Duanyll/LedClock/doc/lab_report(zh_cn).pdf

# 2021 年电子科技大学盟升杯电子设计

竞赛

# 设 计 报 告

# D 题 多功能闹钟

# 2021 年电子科技大学盟升杯电子设计竞赛

设 | 计 | 报 | 告

## 题目：新生组 D 题 多功能小车

## 一、 摘要

## 本小组制作的多功能闹钟主要由 STM32 单片机最小系统、数码管模块、按键

## 模块、光敏电阻模块、稳压电源模块、蜂鸣器模块、DHT11 温湿度传感器模块和备

## 用电池模块组成。本设计采用了双层洞洞板设计，STM32 单片机最小系统板、稳

## 压电源、备用电池位于下层板，数码管、按钮、光敏电阻、温湿度传感器和蜂鸣器

## 等交互模块位于上层板，上下两层板通过排针连接，整体结构设计合理，空间利用

## 率高。用户能通过上下左右四个按键直观地与本作品进行交互，能通过 LED 数码

## 管显示的功能菜单完成时间设置、温湿度查看、闹钟设置等功能。本作品内置了

## 几首蜂鸣器音乐用户选择作为闹钟铃声。除题目要求的功能外，本作品还实现了

## 秒表和倒计时功能。本组的设计能较好地完成多功能闹钟的任务。

## 二、 系统方案

（一）电路载体选择

## 1） 单层洞洞板

## 2） 双层洞洞板

### 3） PCB

选择：（3）

## 分析：单层洞洞板设计、制作和调试难度均较低，但空间利用率不高，不够美

## 观；双层洞洞板将不与用户交互的模块置于背面，同时提供额外空间进行走线，但

## 设计、制作和调试较为复杂；PCB 能提供最稳定和美观的效果，但是设计、加工、

## 调试周期较长，成本较高。综合考虑各种因素后，我们选择使用双层洞洞板。

（二）供电选择

### 1） 自治 LM7805 9V 转 5V 稳压电源模块

### 2） USB 5V 电源输入

## 3） 调试端口 3V3 电源输入

选择：（1）（2）（3）

## 分析：题目要求采用（1）方式供电，但最小系统板自带后两种供电方式支持，

## 配置较为方便。

（三）按钮输入方式选择

## 1） 开漏输出

## 2） 推挽输出，上拉输入

选择：（2）

## 分析：开漏输入需要手动连接上拉电阻，方案 2 通过软件切换 GPIO 引脚的输

## 入方式，可免去上拉电阻，电路设计更加简洁，故采用方案 2。

（四）小结

## 经过小组同学的讨论，我们决定选择在双层洞洞板上制作作品，同时采用三

## 种供电方式，使用上拉电阻模式连接按钮，通过切换 GPIO 模式控制 DHT11 的创

## 新设计方案。

## 三、 理论分析与计算

（一）系统结构的分析

## 3.1.1 系统理论

## 通过对题目要求的分析，多功能闹钟是一个以 STM32 单片机最小系统为控制

## 核心且外附各类组件以完成各项功能的系统。需要外接进行控制的模块有：数码

## 管模块、按键模块、光敏电阻模块、蜂鸣器模块和 DHT11 温湿度传感器模块。

## 3.1.2 数码管模块理论

## 直接将单片机 GPIO 引脚连接数码管阳极和阴极，每次将共阴数码管的一个

## 阴极置为低电平，其余为高电平，将数码需点亮的笔画的阳极置于高电平，其余

## 阳极为低电平，来点亮一位数码，编程控制快速依次点亮四位数码达到同时显示

## 四位数码的效果。为实现显示亮度调节，将阴极四个引脚连接到 STM32 的定时器

## PWM 输出引脚，通过改变 PWM 占空比实现亮度调节。

## 3.1.3 按键模块理论

## 将四个按钮的一端与单片机的四个上拉输入引脚相连，另一端接地。单片机

## 每隔一定时间检测一次按钮引脚电位，按钮未按下时处于高电位，按下时处于低

## 电位。为实现按键防抖，只有连续几次探测到低电位时才出发按键处理程序。

## 3.1.4 光敏电阻模块理论

## 将光敏电阻与一定大小的电阻串联后接在 VCC 与 GND 之间，利用单片机

## ADC 检测光敏电阻和定值电阻之间的电压，即可根据串联分压原理获取光敏电阻

## 阻值，进而获得光线强度。

## 3.1.5 蜂鸣器模块理论

## 采用无源蜂鸣器，向蜂鸣器施加 PWM 方波电压即可控制蜂鸣器发声及发生

## 频率。编程连续按照录入的乐谱改变频率即可实现音乐播放。由于蜂鸣器正常工

## 作时电压和电流较大，而单片机引脚输出电流电压有限，需通过三极管放大电流。

## 3.1.6 DHT11 温湿度传感器模块理论

## DHT11 温湿度传感器通过数字方式与 STM32 主机通信，查阅其技术手册可

## 获得读取数据所用的具体通讯协议，编程实现该协议即可。

（二）相关计算

## 3.2.1 数码管 LED 限流电阻

## 单片机引脚输出电压为 3.3V，LED 工作电流约 2mA，正向电压约 2.6V，计算

## 得需串联约 260Ω 的电阻，通过并联两个 350Ω 电阻来近似实现。

## 3.2.2 与光敏电阻串联的电阻

## 用万用表测得光敏电阻在阴天太阳光下电阻约 2kΩ，完全遮挡约 18kΩ ，串联

## 一个 3.5kΩ 的电阻可以明显测量两端电压变化。

## 3.2.3 音乐播放

## 使用状态机模型驱动音乐播放程序，规定每秒调用音乐播放程序 50 次，结合

## 音乐节奏计算，可得约 3 次循环播放一个十六分音符较为适合。SysTick 计时器频

## 率为 8MHz，除以每个音高的标准频率可计算 PWM 周期。

## 四、 电路设计

（一）系统总体框图

## 系统总体框图已由题目要求给出。

## 下面是各个模块的电路原理图。

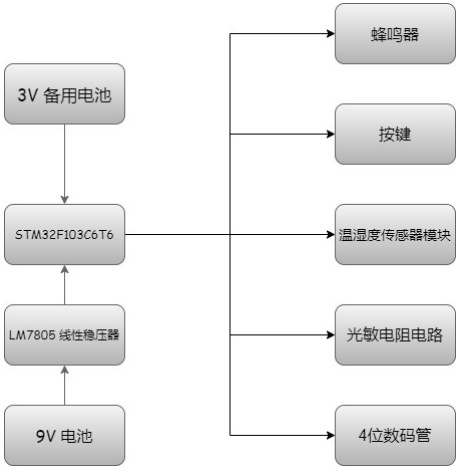
[picture p13: figure]

图 1: 系统总体框图

（二）稳压电源模块


图 2: 稳压电源模块原理图

## 其中 C1 电容用三个 10F 电容并联代替。

（三）备用电池模块

## 通过二极端接入 3.3V 输入，允许主电源接通时不消耗备用电池。使用一个 104

## 滤波电容。

（四）蜂鸣器模块

## 使用 NPN 型三极管 S8050 在接地端控制电流。


图 3: 备用电池模块原理图

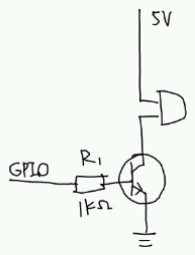
[picture p14: figure]

图 4: 蜂鸣器模块原理图

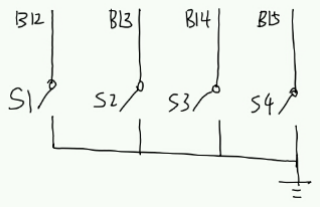
[picture p15: figure]

图 5: 按键模块原理图

（五）按键模块

## 按键一端接单片机上拉输入引脚，一端接地。

（六）DHT11 温湿度传感器模块

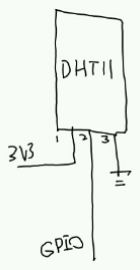
[picture p16: figure]

图 6: DHT11 温湿度传感器模块原理图

## 成品 DHT11 模块已包含电源滤波电容，直接将数据线连接单片机 GPIO。

（七）光敏电阻模块

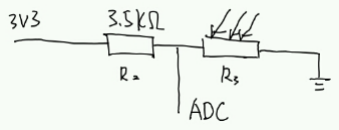
[picture p17: figure]

图 7: 光敏电阻模块原理图

## 光敏电阻阻值随光强减小，则 ADC 读取的电压值与光照强度负相关。

（八）LED 数码管模块

## 12 个管脚均直接由单片机 GPIO 控制。由于阴极数量较少，将限流电阻设置

## 在阴极，并将阴极连接到带 PWM 输出功能的引脚实现亮度调节。

（九）各模块与 STM32 核心板连接

## 4.9.1 单层洞洞板方案

## 我们论证了该方案的可行性，并做出了洞洞板布局设计，但并未实际使用。

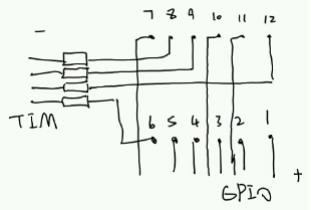
[picture p18: figure]

图 8: LED 数码管模块原理图


图 9: 数码管内部原理图

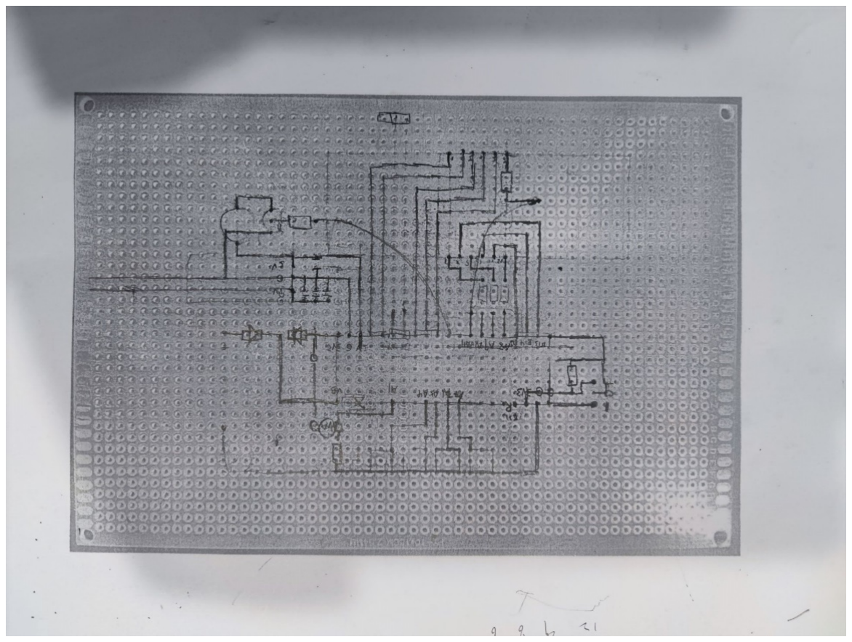
[picture p19: figure]

图 10: 单层洞洞板设计图

## 4.9.2 双层洞洞板方案

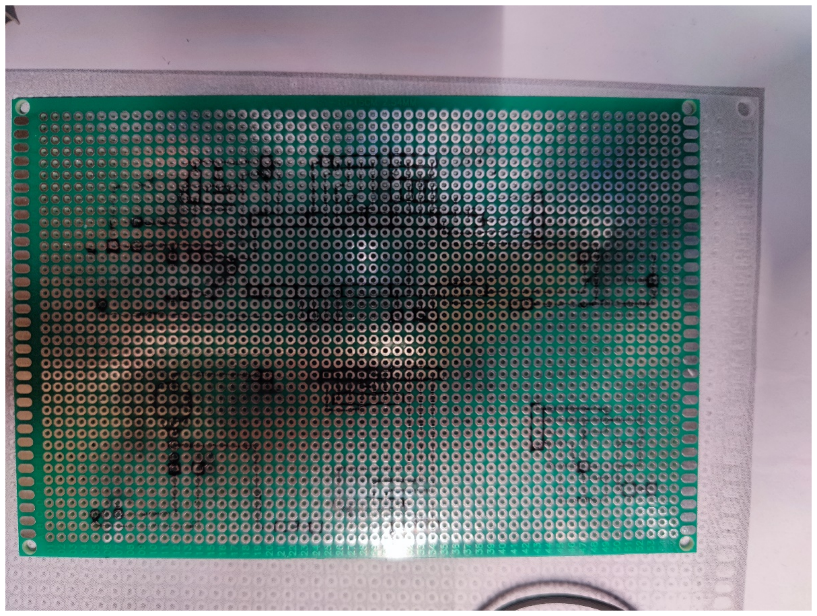
[picture p20: figure]

图 11: 双层洞洞板设计图

## 方便起见，我们直接在洞洞板上绘制了线路连接方案，整体采用紧凑型设计，

## 仅使用一条飞线，其余电路均通过焊锡连接。完成元件焊接和线路焊接后，用美

## 工刀沿中线裁开洞洞板，再利用排针完成上下两层板，下层板和单片机核心板之

## 间的物理连接和电气连接，排针两端均焊死以提升结构强度。主电源开关通过向

## 外弯折的排针固定在下层板侧边。


图 12: CubeMX 管脚配置

## 五、 测试方案与结果

（一）方案论证测试

## 在正式制作开始前，我们制作了一块测试板，通过杜邦线与单片机连接进行

## 各模块测试。

（二）单元测试

## 在连接单片机前，将各模块与稳压电源、函数发生器和多用电表等仪器相连，

## 模拟输入，检测其是否工作正常。

## LED 数码管：将稳压电源调为 3.3V，分别于每个阳极和阴极相连，观察到每

## 个数码管笔画均能正常发光。

## 按钮：将多用电表设置为蜂鸣模式，两表笔接于开关两端，按下按钮时多用电

## 表能发出蜂鸣。

## 光敏电阻：将稳压电源输出 3.3V 电源接入光敏电阻模块，使用多用电表电压

## 档测量光敏电阻两侧电压，在不同光照条件下能在 1.17V 至 2.60V 间变化。

## 稳压电源：在 LM7805 的 1 引脚和 2 引脚间施加 9.0V 电压，使用多用电表电

## 压挡测得引脚 3 和 2 间输出 4.73V 电压，基本符合要求。

## 蜂鸣器：使用稳压电源输出 5.0V 电源，函数发生器产生 2700Hz，3.3Vpp 方

## 波接入模块，能听到蜂鸣器发出响亮声音，且音高能随函数发生器频率变化。

## UART 串口：通过 USB 转 TTL 模块连接单片机的 USART 引脚和电脑并烧录

## 串口测试程序，单片机能正确回传电脑发送的数据。

## DHT11 模块：连接 UART 串口后，编程使单片机每秒向电脑发送一次从 DHT11

## 获取的温湿度数据，基本符合现实情况。

（三）集成测试

## 完成最小系统板的焊接工作，并完成程序编写后，按照用户的正常使用方式

## 测试各项功能是否正常。经测试，时间显示、时间设置、亮度调节、断电走时、温

## 湿度显示、闹钟设置、音乐播放等各项功能均能正常工作。测试时具体操作方式

## 参见附录使用说明。

## 六、 程序设计

（一）主要思路

## 本作品的主要交互方式为 LED 数码管，故整体软件设计围绕数码管显示展开。

## 经过测试，以 50Hz 的频率循环点亮四位数码管不会造成明显的闪烁效果，且延时

## 函数易于编写，故确定刷新率为 50Hz，以 20ms 为一周期进行一轮数码管渲染、数

## 据读取、蜂鸣器控制等操作，实现为以下主 while 循环：

1 | while (1) {
2 | Keys_Tick();
3 | Light_Tick();
4 | App_Tick();
5 | LED_Flush();
6 | UART_Flush();
7 | }
| 代码 1: 主 while 循环

（二）LED 驱动

## 每次通过设置阳极管脚高电平，阴极管脚启动 PWM 来点亮一位数码，保持

## 1ms 后恢复，并驱动下一位数码。每刷新周期重复 20 次，阻塞 20ms。

## 全局变量 display_buffer 用于收集交互逻辑模块绘制的图形，传递给 LED 驱动

## 模块以显示。

1 | static void LED_ShowPos(uint16_t channel, uint16_t ch_pin, uint32_t delay) {
2 | __HAL_TIM_SET_COMPARE(&htim1, channel, brightness);
3
4 | HAL_GPIO_WritePin(GPIOB, ch_pin, GPIO_PIN_SET);
5 | HAL_Delay(delay);
6 | HAL_GPIO_WritePin(GPIOB, ch_pin, GPIO_PIN_RESET);
7
8 | __HAL_TIM_SET_COMPARE(&htim1, channel, 255);
9 | }
10
11 | static void LED_Flush() {
12 | for (int i = 0; i < 5; i++) {

13 | LED_ShowPos(LED_DIG1_CH , display_buffer[0], 1);
14 | LED_ShowPos(LED_DIG2_CH , display_buffer[1], 1);
15 | LED_ShowPos(LED_DIG3_CH , display_buffer[2], 1);
16 | LED_ShowPos(LED_DIG4_CH , display_buffer[3], 1);
17 | }
18 | }
| 代码 2: LED 驱动

（三）按钮防抖判定

## 借助 20ms 周期的主循环，每循环调用一次按钮处理函数，可实现 20ms 间隔

## 的采样，要求连续多次采样成功才触发按键处理，并设置相应标志变量供交互模

## 块处理。采样函数内置静态计数器变量，可实现不同的长按按钮触发方式。

1 | uint8_t key_config[4];
2 | static void Keys_Tick() {
3 | static int hits[4] = {0};
4 | static uint16_t keys[] = {BTN_L_Pin, BTN_R_Pin, BTN_U_Pin, BTN_D_Pin};
5 | for (int i = 0; i < 4; i++) {
6 | GPIO_PinState state = HAL_GPIO_ReadPin(GPIOB, keys[i]);
7 | if (state) {
8 | hits[i] = 0;
9 | key_state[i] = FALSE;
10 | } else {
11 | hits[i]++;
12 | switch (key_config[i]) {
13 | case KEY_MODE_ONCE:
14 | if (hits[i] == 2) {
15 | key_state[i] = TRUE;
16 | } else {
17 | key_state[i] = FALSE;
18 | }
19 | break;
20 | case KEY_MODE_LONG:
21 | if (hits[i] == 2 || (hits[i] > 0 && hits[i] % 10 == 0))
| {
22 | key_state[i] = TRUE;
23 | } else {
24 | key_state[i] = FALSE;
25 | }
26 | break;
27 | case KEY_MODE_LONG_ACC:
28 | if (hits[i] == 2 ||
29 | (hits[i] >= 10 && hits[i] <= 50 && hits[i] % 10 ==
0) ||
30 | (hits[i] > 50 && hits[i] <= 100 && hits[i] % 4 == 0)
31 | hits[i] > 100) {
32 | key_state[i] = TRUE;
33 | } else {
34 | key_state[i] = FALSE;
35 | }
36 | break;
37 | }
38 | }
39 | }
40 | }
| 代码 3: 按钮防抖判定

（四）UART 通信

## 为节省 Flash 空间，放弃使用printf系列函数，转而使用几个简单函数将字符

## 串、整数等内容发送到缓冲区，并随显示周期冲刷缓冲区。通过中断方式无阻塞

## 接受数据，用 # 号字符标记可变长度指令结束，并触发指令处理。

1 | struct {
2 | char *tx_cur;
3 | char tx[256];
4 | char *rx_cur;
5 | char rx[32];
6 | } uart_buf;
7
8 | void UART_Init() {
9 | uart_buf.tx_cur = uart_buf.tx;
10 | uart_buf.rx_cur = uart_buf.rx;
11 | HAL_UART_Receive_IT(&huart2, uart_buf.rx_cur, 1);
12 | }
13
14 | void UART_Write_Text(const char *text) {
15 | while (*text != ’ \ 0 ’) {
16 | *uart_buf.tx_cur = *text;
17 | text++;
18 | uart_buf.tx_cur++;
19 | }
20 | }
21 | void UART_Write_NewLine() { UART_Write_Text(” \ n”); }
22 | void UART_Write_Int(int x) {
23 | if (x < 0) {
24 | *uart_buf.tx_cur = ’−’;
25 | uart_buf.tx_cur++;
26 | UART_Write_Int(‐x);
27 | return;
28 | }
29 | if (x >= 10) {
30 | UART_Write_Int(x / 10);
31 | }
32 | *uart_buf.tx_cur = x % 10 + ’ 0 ’;
33 | uart_buf.tx_cur++;
34 | }
35 | void UART_Flush() {
36 | if (uart_buf.tx_cur > uart_buf.tx) {
37 | HAL_UART_Transmit_IT(&huart2, uart_buf.tx,
38 | uart_buf.tx_cur ‐ uart_buf.tx);
39 | uart_buf.tx_cur = uart_buf.tx;
40 | }
41 | }
42
43 | void HAL_UART_RxCpltCallback(UART_HandleTypeDef *huart) {
44 | if (*uart_buf.rx_cur == ’ # ’) {
45 | UART_OnData();
46 | uart_buf.rx_cur = uart_buf.rx;
47 | } else {
48 | uart_buf.rx_cur++;
49 | }
50 | HAL_UART_Receive_IT(&huart2, uart_buf.rx_cur, 1);
51 | }
| 代码 4: UART 通信

（五）亮度调节

## LED 显示模块读取 brightness全局变量设置 PWM 占空比。同样借助 20ms 的

## 刷新周期实现亮度无级调节。

## 通过内置的静态计时器变量，控制每秒获取一次 ADC 数据。

1 | static void Light_Tick() {
2 | int expected = (current_light / 16);
3 | if (expected > 240) {
4 | expected = 240;
5 | }
6 | if (brightness < expected) {
7 | brightness++;
8 | } else if (brightness > expected) {
9 | brightness ‐‐;
10 | }
11 | static int hits = 0;
12 | hits++;
13 | if (hits >= 50) {
14 | hits = 0;
15 | HAL_ADC_Start_IT(&hadc1);
16 | }
17 | }
18
19 | void HAL_ADC_ConvCpltCallback(ADC_HandleTypeDef *hadc) {
20 | / / Read & Update The ADC R e s u l t
21 | current_light = HAL_ADC_GetValue(hadc);
22 | }
| 代码 5: 亮度控制

（六）闹铃与音乐

## 编写一个辅助函数用于设置蜂鸣器状态。

1 | static void Alarm_SetState(BOOL is_on, uint16_t period) {
2 | static BOOL ring_flag = FALSE;
3 | static uint16_t last_period = 0;
4 | if (period != last_period) {
5 | __HAL_TIM_SetCounter(&htim2, 0);
6 | __HAL_TIM_SET_AUTORELOAD(&htim2, period);
7 | __HAL_TIM_SET_COMPARE(&htim2, TIM_CHANNEL_2 , (period >> 1));
8 | last_period = period;
9 | }
10 | if (is_on && !ring_flag) {
11 | HAL_TIM_PWM_Start(&htim2, TIM_CHANNEL_2);
12 | ring_flag = 1;
13 | return;
14 | }
15 | if (!is_on && ring_flag) {
16 | HAL_TIM_PWM_Stop(&htim2, TIM_CHANNEL_2);
17 | ring_flag = 0;
18 | return;
19 | }
20 | }
| 代码 6: 设置闹铃状态

## 闹铃时间、是否开启闹铃、闹铃音乐等选项保存在 RTC 备份寄存器中，可在

## 主电源恢复后读取。

## 音乐以十六分音符为单位拆分，每个十六分音符利用 4bit 编码，再额外存储

## 音符的标准音高对应的周期，格式如下：

1 | #define ZENBON_ZAKURA_LENGTH 80
2 | #define ZENBON_ZAKURA_SPEED 2
3 | uint32_t zenbon_zakura_data[] = {
4 | 0x91a16565, 0x91a16565, 0x91a16565, 0x81716151, 0x91a16565, 0x91a16565,

5 | 0x91a1c1f1, 0xefedc1a1, 0x91a16565, 0x91a16565, 0x91a16565, 0x81716151,
6 | ...
7 | 0x911911a1, 0xa11111a1, 0xc1d19181, 0xa1116181, 0xb111a111, 0x91118111,
8 | 0x9181a1c1, 0xd1111111,
9
10 };
11
12 | uint16_t note_period_f[] = {0, | 0, | 20408, 18181, 17167, 15296,
13 | 13628, 12139, 11461, 10204, 9090, | 8583,
14 | 7648, | 6808, | 6065, | 5726};

代码 7: 音乐存储格式

## 播放时，利用 20ms 的周期，不断驱动指针递增，实现音乐解码播放。

1 | static void Alarm_TickMusic() {
2 | if (music_ptr == NULL || music_ptr >= music_end) {
3 | Alarm_StopMusic();
4 | return;
5 | };
6 | music_tick++;
7 | if (music_tick % music_speed == 0) {
8 | music_alt++;
9 | if (music_alt >= 8) {
10 | music_alt = 0;
11 | music_ptr++;
12 | if (music_ptr >= music_end) {
13 | Alarm_StopMusic();
14 | return;
15 | }
16 | }
17 | }
18 | int cur = ((*music_ptr) >> ((7 ‐ music_alt) * 4)) & 0xF;
19 | if (cur == 0) {
20 | Alarm_SetState(FALSE, note_period[last_note]);
21 | } else if (cur == 1) {
22 | Alarm_SetState(TRUE, note_period[last_note]);
23 | } else {
24 | if (music_tick % music_speed != 0) {
25 | Alarm_SetState(TRUE, note_period[cur]);
26 | last_note = cur;
27 | } else {
28 | Alarm_SetState(FALSE, note_period[cur]);
29 | }
30 | }
31 | }

代码 8: 音乐解码播放

（七）DHT11

## DHT11 对操作时序的要求较高，故采取阻塞等待的方式读取数据。设置读取

## 超时为 1ms，用户几乎感知不到造成的显示停顿。利用 SysTick 实现微秒级延时。

1 | static void delay_us(uint32_t us) {
2 | __IO uint32_t currentTicks = SysTick‐>VAL;
3 | / * Number o f t i c k s p e r m i l l i s e c o n d * /
4 | const uint32_t tickPerMs = SysTick‐>LOAD + 1;
5 | / * Number o f t i c k s t o c o u nt * /
6 | const uint32_t nbTicks = ((us ‐ ((us > 0) ? 1 : 0)) * tickPerMs) / 1000;
7 | / * Number o f e l a p s e d t i c k s * /
8 | uint32_t elapsedTicks = 0;
9 | __IO uint32_t oldTicks = currentTicks;
10 | do {
11 | currentTicks = SysTick‐>VAL;

12 | elapsedTicks += (oldTicks < currentTicks)
13 | ? tickPerMs + oldTicks ‐ currentTicks
14 | : oldTicks ‐ currentTicks;
15 | oldTicks = currentTicks;
16 | } while (nbTicks > elapsedTicks);
17 | }
18
19 | void Set_Pin_Output(GPIO_TypeDef *GPIOx, uint16_t GPIO_Pin) {
20 | GPIO_InitTypeDef GPIO_InitStruct = {0};
21 | GPIO_InitStruct.Pin = GPIO_Pin;
22 | GPIO_InitStruct.Mode = GPIO_MODE_OUTPUT_PP;
23 | GPIO_InitStruct.Speed = GPIO_SPEED_FREQ_LOW;
24 | HAL_GPIO_Init(GPIOx, &GPIO_InitStruct);
25 | }
26
27 | void Set_Pin_Input(GPIO_TypeDef *GPIOx, uint16_t GPIO_Pin) {
28 | GPIO_InitTypeDef GPIO_InitStruct = {0};
29 | GPIO_InitStruct.Pin = GPIO_Pin;
30 | GPIO_InitStruct.Mode = GPIO_MODE_INPUT;
31 | GPIO_InitStruct.Pull = GPIO_PULLUP;
32 | HAL_GPIO_Init(GPIOx, &GPIO_InitStruct);
33 | }
34
35 | void DHT11_Start(void) {
36 | Set_Pin_Output(DHT11_GPIO_Port , DHT11_Pin);
37 | HAL_GPIO_WritePin(DHT11_GPIO_Port , DHT11_Pin, 0);
38 | delay_us(18000);
39 | HAL_GPIO_WritePin(DHT11_GPIO_Port , DHT11_Pin, 1);
40 | delay_us(20);
41 | Set_Pin_Input(DHT11_GPIO_Port , DHT11_Pin);
42 | }
43
44 | int DHT11_WaitFor(int state) {
45 | int timer = 0;
46 | while (HAL_GPIO_ReadPin(DHT11_GPIO_Port , DHT11_Pin) != state) {
47 | delay_us(1);
48 | timer++;
49 | if (timer > 1000) {
50 | return 1;
51 | }
52 | }
53 | return 0;
54 | }
55
56 | uint8_t DHT11_Check_Response(void) {
57 | uint8_t Response = 0;
58
59 | delay_us(40);
60 | if (!(HAL_GPIO_ReadPin(DHT11_GPIO_Port , DHT11_Pin))) {
61 | delay_us(80);
62 | if ((HAL_GPIO_ReadPin(DHT11_GPIO_Port , DHT11_Pin)))
63 | Response = 1;
64 | else
65 | Response = ‐1;
66 | }
67 | if (DHT11_WaitFor(0)) return ‐1;
68
69 | return Response;
70 | }
71
72 | uint8_t DHT11_Read(void) {
73 | uint8_t i = 0, j = 0;
74 | for (j = 0; j < 8; j++) {
75 | if (DHT11_WaitFor(1)) return 0;
76 | delay_us(40);
77 | if (!(HAL_GPIO_ReadPin(DHT11_GPIO_Port , DHT11_Pin))) {
78 | i &= ~(1 << (7 ‐ j));
79 | } else
80 | i |= (1 << (7 ‐ j));
81 | if (DHT11_WaitFor(0)) return 0;

}
return i;
}

static void DHT11_Run() {
DHT11_Start();
int Presence = DHT11_Check_Response(); if (Presence == 1) {
uint8_t Rh_byte1 = DHT11_Read(); uint8_t Rh_byte2 = DHT11_Read(); uint8_t Temp_byte1 = DHT11_Read();
uint8_t Temp_byte2 = DHT11_Read();
uint8_t SUM = DHT11_Read();

if (Rh_byte1 + Rh_byte2 + Temp_byte1 + Temp_byte2 != SUM) { UART_Write_Text(”DHT11 v a l i d a t i o n f a i l e d . ”);
}

temp = Temp_byte1;
humi = Rh_byte1;
UART_Write_Text(”Temp : ”); UART_Write_Int(temp);
UART_Write_NewLine();
UART_Write_Text(”RH: ”);
UART_Write_Int(humi);
} else {
UART_Write_Text(”No r e s p o n s e f r om DHT11”); }
}

代码 9: DHT11

（八）交互逻辑

## 借助状态机模型实现。参见附录使用说明及完整代码。

## 附录一 使用说明

## 本作品的各种功能由数码管上显示的各“页面”实现，各个页面之间通过上

## 下左右方向键进行导航。下面分别介绍各个页面。

## 主页：显示当前时间。左右键切换时分显示，上下键进入菜单页面。

## 菜单：菜单页共有 8 个选项，可利用方向键移动光标选择选项，光标在上排时

## 按上，下排按下可确认当前选项。选项从左到右，从上到下编号为 1 到 8。

## 时间设置（选项 1）：按左右键切换光标位置，上下键调整事件值。在最左侧

## 按左键放弃修改返回主页，最右侧按右键保存修改返回主页。

## 温湿度显示（选项 2）：首先显示温度（单位：摄氏度），按右键显示湿度（单

## 位：%），再按右键返回主页。

## 倒计时定时器（选项 3）：首先设置倒计时时长，从左到右依次设置时、分、

## 秒，按左右键切换光标位置，上下键调整数值（长按上下键可快速调整），设置完

## 秒钟后按右键开始倒计时。倒计时页面下，按左右键切换时：分、分：秒，秒：毫

## 秒显示，按上键暂停或恢复倒计时，暂停时按下键退出到主页。倒计时结束后将

## 播放闹钟铃声，按任意键返回主页。

## 秒表（选项 4）：按左右键切换时：分、分：秒，秒：毫秒显示，按上键暂停

## 或恢复秒表，暂停时按下键归零，归零后按下键退出到主页。

## 闹钟开关（选项 5）：选择选项后切换闹钟开关。选项右侧小数点指示当前闹

## 钟开关状态。

## 闹钟设置（选项 6）：操作类似时间设置。

## 曲目选择（选项 7）：上下键选择闹铃曲目，选择 0 取消音乐闹铃，右键试听，

## 左键返回主页。

## 返回主页（选项 8）。

## 闹钟页面：启用闹钟，到达闹钟设定时间并位于主页时进入闹钟页面，屏幕闪

## 烁并播放设置的音乐闹铃。音乐播放完或任意键按下后返回到主页。

（一）UART 指令

### 1） T122354# 设置时间为 12:23:54。

### 2） A083000# 设置闹钟时间为 08:30:00。

## 3） I# 回显当前时间、闹铃时间。

## 4） H# 回显温湿度传感器数据。

## 5） K0# 模拟按下左键。

## 6） K1# 模拟按下右键。

## 7） K2# 模拟按下上键。

## 8） K3# 模拟按下下键。

## 附录二 完整代码

## 篇幅所限，见https://github.com/Duanyll/LedClock
