Duanyll/LedClock/doc/imgs/image13.jpeg

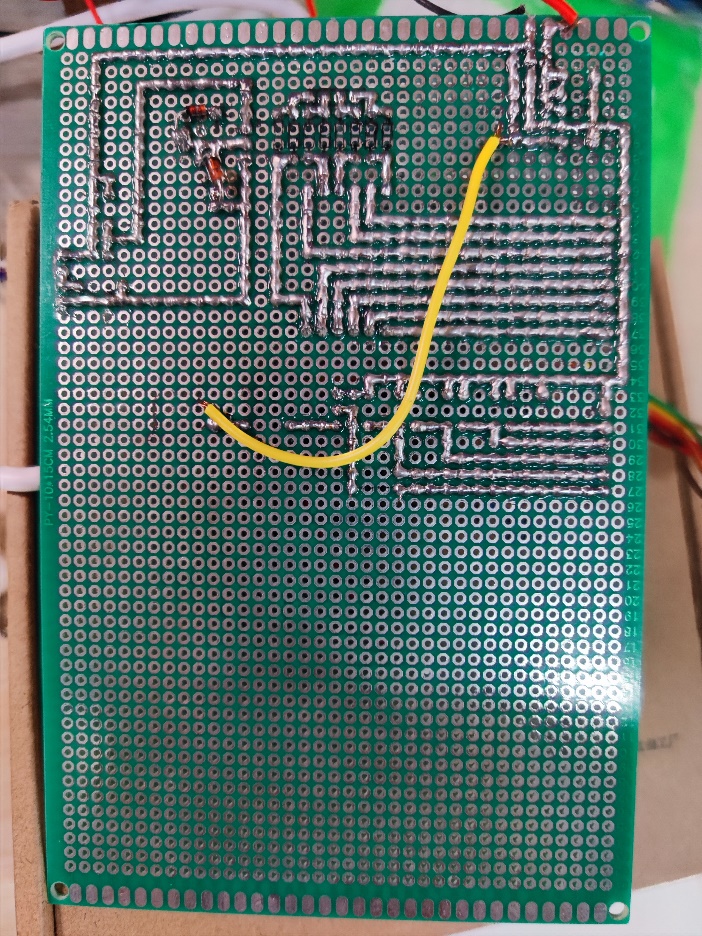
doc/imgs/image13.jpeg
