Duanyll/LedClock/doc/imgs/image14.jpeg

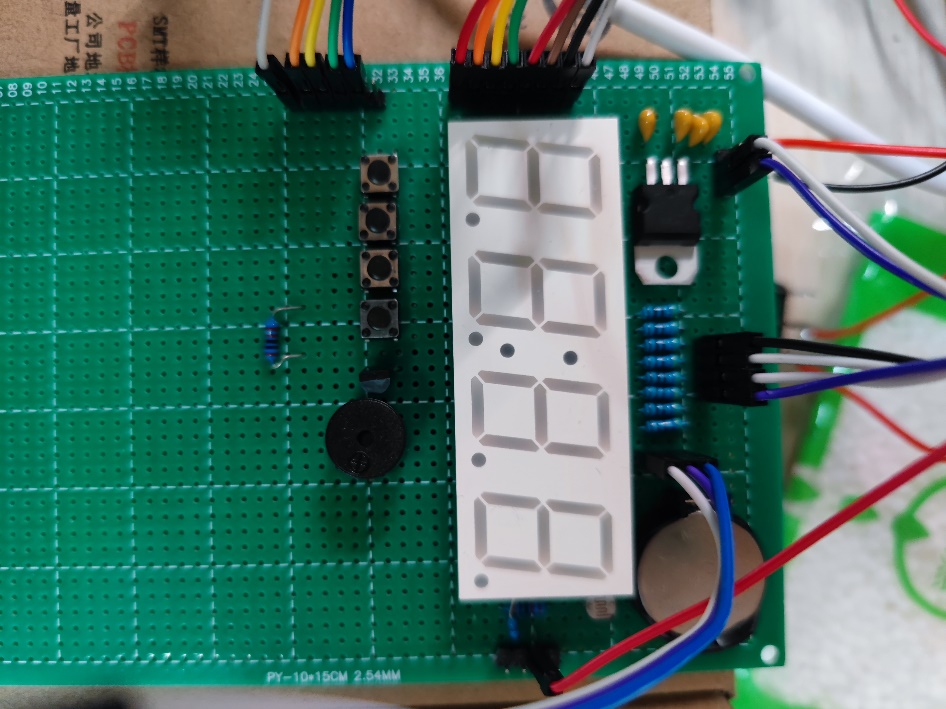
doc/imgs/image14.jpeg
