Duanyll/LedClock/Core/Src/main.c

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
/* Includes ------------------------------------------------------------------*/
#include "main.h"
#include "adc.h"
#include "iwdg.h"
#include "rtc.h"
#include "tim.h"
#include "usart.h"
#include "gpio.h"

/* USER CODE BEGIN Includes */
#include <string.h>
/* USER CODE END Includes */

/* USER CODE BEGIN PTD */
typedef unsigned char BOOL;
/* USER CODE END PTD */

/* USER CODE BEGIN PD */
#define TRUE 1
#define FALSE 0

#define LED_DIG1_CH TIM_CHANNEL_3
#define LED_DIG2_CH TIM_CHANNEL_2
#define LED_DIG3_CH TIM_CHANNEL_1
#define LED_DIG4_CH TIM_CHANNEL_4

#define KEY_ID_L 0
#define KEY_ID_R 1
#define KEY_ID_U 2
#define KEY_ID_D 3

#define KEY_L key_state[KEY_ID_L]
#define KEY_R key_state[KEY_ID_R]
#define KEY_U key_state[KEY_ID_U]
#define KEY_D key_state[KEY_ID_D]

#define KEY_MODE_ONCE 0
#define KEY_MODE_LONG 1
#define KEY_MODE_LONG_ACC 2

#define MUSIC_NYAN_CAT 1
#define MUSIC_ONLY_MY_RAILGUN 2
#define MUSIC_ZENBON_ZAKURA 3

#define LOOP_CYCLE_MS 20

#define PAGE_HOME 0
// #define PAGE_MS 1
#define PAGE_ALARM 2
#define PAGE_MENU 3
#define PAGE_SET_TIME 4
#define PAGE_TEMP_HUMI 5
#define PAGE_SET_ALARM 6
#define PAGE_MUSIC 7
#define PAGE_STOPWATCH 8
#define PAGE_COUNTDOWN 9

#define SCREEN_HM 0
#define SCREEN_MS 1
#define SCREEN_SM 2
/* USER CODE END PD */


/* USER CODE BEGIN PV */
uint16_t display_buffer[4];
int brightness, current_light;
BOOL uart_key_req[4];
BOOL key_state[4];

int second_timestamp = 0;

int page;

uint8_t temp = 20, humi = 68;

BOOL enable_alarm;
RTC_TimeTypeDef alarm_time;
RTC_TimeTypeDef sTime;
int alarm_music;
/* USER CODE END PV */

void SystemClock_Config(void);
/* USER CODE BEGIN PFP */
static void delay_us(uint32_t us);

static uint16_t LED_GetFont(char ch);
static void LED_Flush();

static void Display_SetChar(const char *chs, BOOL colon);
static void Display_SetInt(int x);
static void Display_SetCurrentTimeHM();
static void Display_SetCurrentTimeMS();
static void Display_SetTimestamp(int timestamp, int screen);

static void Alarm_SetState(BOOL is_on, uint16_t period);
static void Alarm_Load();
static void Alarm_Save();
static void Alarm_InitMusic(int id);
static void Alarm_TickMusic();
static void Alarm_StopMusic();

void DHT11_Start(void);
static void DHT11_Run();

static void Keys_Tick();
static void Keys_SetMode(int key, uint8_t mode);

static void Light_Tick();

void UART_Init();
void UART_Write_Text(const char *text);
void UART_Write_NewLine();
void UART_Write_Int(int x);
void UART_Flush();
void UART_OnData();

static void App_Tick();
static void App_HomePage();
// static void App_MSPage();
static void App_AlarmPage();
static void App_MenuPage();
static void App_SetTimePage();
static void App_TempHumiPage();
static void App_SetAlarmPage();
static void App_MusicPage();
static void App_StopwatchPage();
static void App_CountdownPage();
/* USER CODE END PFP */

/**
  * @brief  The application entry point.
  * @retval int
  */
int main(void)
{
  /* MCU Configuration--------------------------------------------------------*/

  /* Reset of all peripherals, Initializes the Flash interface and the Systick. */
  HAL_Init();

  /* Configure the system clock */
  SystemClock_Config();

    /* Initialize all configured peripherals */

    // Add comment
    MX_GPIO_Init();
    MX_ADC1_Init();
    MX_RTC_Init();
    MX_TIM1_Init();
    MX_TIM2_Init();
    MX_USART2_UART_Init();
    MX_TIM3_Init();
    MX_IWDG_Init();
    /* USER CODE BEGIN 2 */
    HAL_TIM_Base_Start(&htim3);
    UART_Init();
    HAL_ADCEx_Calibration_Start(&hadc1);
    DHT11_Start();
    Alarm_Load();
    HAL_RTC_GetTime(&hrtc, &sTime, RTC_FORMAT_BCD);
    HAL_RTCEx_SetSecond_IT(&hrtc);
    UART_Write_Text("---LedClock---");
    UART_Flush();

    brightness = 0;
    page = PAGE_HOME;
    HAL_TIM_PWM_Start(&htim1, TIM_CHANNEL_1);
    HAL_TIM_PWM_Start(&htim1, TIM_CHANNEL_2);
    HAL_TIM_PWM_Start(&htim1, TIM_CHANNEL_3);
    HAL_TIM_PWM_Start(&htim1, TIM_CHANNEL_4);

  /* USER CODE END 2 */

  /* Infinite loop */
  /* USER CODE BEGIN WHILE */
    while (1) {
    /* USER CODE END WHILE */

    /* USER CODE BEGIN 3 */
        Keys_Tick();
        Light_Tick();
        App_Tick();
        LED_Flush();
        UART_Flush();
        HAL_IWDG_Refresh(&hiwdg);
    }
  /* USER CODE END 3 */
}

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
/* USER CODE BEGIN 4 */

/* -------------------------------------------------------------------------- */
/*                                    TIMER                                   */
/* -------------------------------------------------------------------------- */

void HAL_RTCEx_RTCEventCallback(RTC_HandleTypeDef *hrtc) {
    HAL_RTC_GetTime(hrtc, &sTime, RTC_FORMAT_BCD);
    __HAL_TIM_SetCounter(&htim3, 0);
    second_timestamp++;
    if (second_timestamp > 100000 && page != PAGE_STOPWATCH &&
        page != PAGE_COUNTDOWN) {
        second_timestamp = 0;
    }
}

/* -------------------------------------------------------------------------- */
/*                               LED AND DISPLAY                              */
/* -------------------------------------------------------------------------- */

static uint16_t LED_GetFont(char ch) {
    switch (ch) {
        case '0':
            return LED_A_Pin | LED_B_Pin | LED_C_Pin | LED_D_Pin | LED_E_Pin |
                   LED_F_Pin;
        case '1':
            return LED_B_Pin | LED_C_Pin;
        case '2':
            return LED_A_Pin | LED_B_Pin | LED_G_Pin | LED_E_Pin | LED_D_Pin;
        case '3':
            return LED_A_Pin | LED_B_Pin | LED_C_Pin | LED_D_Pin | LED_G_Pin;
        case '4':
            return LED_F_Pin | LED_G_Pin | LED_B_Pin | LED_C_Pin;
        case '5':
            return LED_A_Pin | LED_F_Pin | LED_G_Pin | LED_C_Pin | LED_D_Pin;
        case '6':
            return LED_A_Pin | LED_F_Pin | LED_G_Pin | LED_C_Pin | LED_E_Pin |
                   LED_D_Pin;
        case '7':
            return LED_A_Pin | LED_B_Pin | LED_C_Pin;
        case '8':
            return LED_A_Pin | LED_B_Pin | LED_C_Pin | LED_D_Pin | LED_E_Pin |
                   LED_F_Pin | LED_G_Pin;
        case '9':
            return LED_A_Pin | LED_B_Pin | LED_C_Pin | LED_D_Pin | LED_F_Pin |
                   LED_G_Pin;
        case '_':
            return LED_D_Pin;
        default:
            return 0;
    }
}

static void LED_ShowPos(uint16_t channel, uint16_t ch_pin, uint32_t delay) {
    __HAL_TIM_SET_COMPARE(&htim1, channel, brightness);

    HAL_GPIO_WritePin(GPIOB, ch_pin, GPIO_PIN_SET);
    HAL_Delay(delay);
    HAL_GPIO_WritePin(GPIOB, ch_pin, GPIO_PIN_RESET);

    __HAL_TIM_SET_COMPARE(&htim1, channel, 255);
}

static void LED_Flush() {
    for (int i = 0; i < 5; i++) {
        LED_ShowPos(LED_DIG1_CH, display_buffer[0], 1);
        LED_ShowPos(LED_DIG2_CH, display_buffer[1], 1);
        LED_ShowPos(LED_DIG3_CH, display_buffer[2], 1);
        LED_ShowPos(LED_DIG4_CH, display_buffer[3], 1);
    }
}

static void Display_SetChar(const char *chs, BOOL colon) {
    for (int i = 0; i < 4; i++) {
        display_buffer[i] = LED_GetFont(chs[i]);
    }
    if (colon) {
        display_buffer[1] |= LED_DP_Pin;
    }
}

static void Display_SetInt(int x) {
    display_buffer[3] = LED_GetFont(x % 10 + '0');
    x /= 10;
    display_buffer[2] = LED_GetFont(x % 10 + '0');
    x /= 10;
    display_buffer[1] = LED_GetFont(x % 10 + '0');
    x /= 10;
    display_buffer[0] = LED_GetFont(x % 10 + '0');
}

static void Display_SetCurrentTimeHM() {
    char buf[4] = {sTime.Hours / 16 + '0', sTime.Hours % 16 + '0',
                   sTime.Minutes / 16 + '0', sTime.Minutes % 16 + '0'};

    Display_SetChar(buf, sTime.Seconds & 1);
}

static void Display_SetCurrentTimeMS() {
    char buf[4] = {sTime.Minutes / 16 + '0', sTime.Minutes % 16 + '0',
                   sTime.Seconds / 16 + '0', sTime.Seconds % 16 + '0'};

    Display_SetChar(buf, TRUE);
}

static void Display_SetTimestamp(int timestamp, int screen) {
    char buf[4] = {0};
    int second = timestamp / 1000;
    int ms = timestamp % 1000;
    int hours = second / 3600;
    int minutes = (second % 3600) / 60;
    int seconds = second % 60;
    switch (screen) {
        case SCREEN_HM:
            buf[0] = hours / 10 + '0';
            buf[1] = hours % 10 + '0';
            buf[2] = minutes / 10 + '0';
            buf[3] = minutes % 10 + '0';
            Display_SetChar(buf, seconds & 1);
            break;
        case SCREEN_MS:
            buf[0] = minutes / 10 + '0';
            buf[1] = minutes % 10 + '0';
            buf[2] = seconds / 10 + '0';
            buf[3] = seconds % 10 + '0';
            Display_SetChar(buf, TRUE);
            break;
        case SCREEN_SM:
            buf[0] = seconds / 10 + '0';
            buf[1] = seconds % 10 + '0';
            buf[2] = ms / 100 + '0';
            buf[3] = (ms % 100) / 10 + '0';
            Display_SetChar(buf, TRUE);
            break;
    }
}

/* -------------------------------------------------------------------------- */
/*                                  KEY INPUT                                 */
/* -------------------------------------------------------------------------- */

uint8_t key_config[4];
static void Keys_Tick() {
    static int hits[4] = {0};
    static uint16_t keys[] = {BTN_L_Pin, BTN_R_Pin, BTN_U_Pin, BTN_D_Pin};
    for (int i = 0; i < 4; i++) {
        if (uart_key_req[i]) {
            key_state[i] = TRUE;
            uart_key_req[i] = FALSE;
            continue;
        }
        GPIO_PinState state = HAL_GPIO_ReadPin(GPIOB, keys[i]);
        if (state) {
            hits[i] = 0;
            key_state[i] = FALSE;
        } else {
            hits[i]++;
            switch (key_config[i]) {
                case KEY_MODE_ONCE:
                    if (hits[i] == 2) {
                        key_state[i] = TRUE;
                    } else {
                        key_state[i] = FALSE;
                    }
                    break;
                case KEY_MODE_LONG:
                    if (hits[i] == 2 || (hits[i] > 0 && hits[i] % 10 == 0)) {
                        key_state[i] = TRUE;
                    } else {
                        key_state[i] = FALSE;
                    }
                    break;
                case KEY_MODE_LONG_ACC:
                    if (hits[i] == 2 ||
                        (hits[i] >= 10 && hits[i] <= 50 && hits[i] % 10 == 0) ||
                        (hits[i] > 50 && hits[i] <= 100 && hits[i] % 4 == 0) ||
                        hits[i] > 100) {
                        key_state[i] = TRUE;
                    } else {
                        key_state[i] = FALSE;
                    }
                    break;
            }
        }
    }
}

static void Keys_SetMode(int key, uint8_t mode) { key_config[key] = mode; }

/* -------------------------------------------------------------------------- */
/*                                    USART                                   */
/* -------------------------------------------------------------------------- */

struct {
    char *tx_cur;
    char tx[256];
    char *rx_cur;
    char *rx_end;
    char rx[32];
} uart_buf;

void UART_Init() {
    uart_buf.tx_cur = uart_buf.tx;
    uart_buf.rx_cur = uart_buf.rx;
    uart_buf.rx_end = uart_buf.rx + 32;
    HAL_UART_Receive_IT(&huart2, uart_buf.rx_cur, 1);
}

void UART_Write_Text(const char *text) {
    while (*text != '\0') {
        *uart_buf.tx_cur = *text;
        text++;
        uart_buf.tx_cur++;
    }
}
void UART_Write_NewLine() { UART_Write_Text("\n"); }
void UART_Write_Int(int x) {
    if (x < 0) {
        *uart_buf.tx_cur = '-';
        uart_buf.tx_cur++;
        UART_Write_Int(-x);
        return;
    }
    if (x >= 10) {
        UART_Write_Int(x / 10);
    }
    *uart_buf.tx_cur = x % 10 + '0';
    uart_buf.tx_cur++;
}

void UART_Write_Time(RTC_TimeTypeDef *time) {
    UART_Write_Int(time->Hours >> 4);
    UART_Write_Int(time->Hours % 16);
    UART_Write_Text(":");
    UART_Write_Int(time->Minutes >> 4);
    UART_Write_Int(time->Minutes % 16);
    UART_Write_Text(":");
    UART_Write_Int(time->Seconds >> 4);
    UART_Write_Int(time->Seconds % 16);
}

BOOL UART_Parse_Time(int x, RTC_TimeTypeDef *time) {
    int digits[6] = {0};
    for (int i = 0; i < 6; i++) {
        digits[i] = x % 10;
        x /= 10;
    }
    if (digits[5] * 10 + digits[4] < 24 && digits[3] * 10 + digits[2] < 60 &&
        digits[1] * 10 + digits[0] < 60) {
        time->Seconds = (digits[1] << 4) + digits[0];
        time->Minutes = (digits[3] << 4) + digits[2];
        time->Hours = (digits[5] << 4) + digits[4];
        return TRUE;
    } else {
        return FALSE;
    }
}

void UART_Flush() {
    if (uart_buf.tx_cur > uart_buf.tx) {
        HAL_UART_Transmit_IT(&huart2, uart_buf.tx,
                             uart_buf.tx_cur - uart_buf.tx);
        uart_buf.tx_cur = uart_buf.tx;
    }
}

void HAL_UART_RxCpltCallback(UART_HandleTypeDef *huart) {
    if (*uart_buf.rx_cur == '#') {
        UART_OnData();
        uart_buf.rx_cur = uart_buf.rx;
    } else {
        uart_buf.rx_cur++;
        if (uart_buf.rx_cur >= uart_buf.rx_end) {
            UART_Write_Text("Uart RX buffer overflow!");
            UART_Flush();
            uart_buf.rx_cur = uart_buf.rx;
        }
    }
    HAL_UART_Receive_IT(&huart2, uart_buf.rx_cur, 1);
}

void UART_OnData() {
    int x = 0;
    char *cur = uart_buf.rx;
    char command = *cur;
    cur++;
    while (*cur >= '0' && *cur <= '9') {
        x *= 10;
        x += *cur - '0';
        cur++;
    }
    switch (command) {
        case 'T':
            if (UART_Parse_Time(x, &sTime)) {
                HAL_RTC_SetTime(&hrtc, &sTime, RTC_FORMAT_BCD);
                UART_Write_Text("Time set to ");
                UART_Write_Time(&sTime);
            } else {
                UART_Write_Text("Illegal time.");
            }
            break;
        case 'A':
            if (UART_Parse_Time(x, &alarm_time)) {
                Alarm_Save();
                UART_Write_Text("Alarm set to ");
                UART_Write_Time(&alarm_time);
            } else {
                UART_Write_Text("Illegal time.");
            }
            break;
        case 'I':
            UART_Write_Text("Current time: ");
            UART_Write_Time(&sTime);
            UART_Write_NewLine();
            UART_Write_Text("Alarm time: ");
            UART_Write_Time(&alarm_time);
            UART_Write_NewLine();
            UART_Write_Text("Alarm enabled: ");
            if (enable_alarm) {
                UART_Write_Text("true");
            } else {
                UART_Write_Text("false");
            }
            UART_Write_NewLine("Current light: ");
            UART_Write_Int(current_light);
            break;
        case 'H':
            DHT11_Run();
            break;
        case 'K':
            if (x >= 0 && x < 4) {
                uart_key_req[x] = TRUE;
                UART_Write_Text("Key pressed.");
            } else {
                UART_Write_Text("Unknown key.");
            }
            break;
        default:
            UART_Write_Text("Unknown command.");
            break;
    }
    UART_Write_NewLine();
}

/* -------------------------------------------------------------------------- */
/*                             BRIGHTNESS CONTROL                             */
/* -------------------------------------------------------------------------- */

static void Light_Tick() {
    int expected = (current_light / 16);
    if (expected > 240) {
        expected = 240;
    }
    if (brightness < expected) {
        brightness++;
    } else if (brightness > expected) {
        brightness--;
    }
    static int hits = 0;
    hits++;
    if (hits >= 50) {
        hits = 0;
        HAL_ADC_Start_IT(&hadc1);
    }
}

void HAL_ADC_ConvCpltCallback(ADC_HandleTypeDef *hadc) {
    // Read & Update The ADC Result
    current_light = HAL_ADC_GetValue(hadc);
}

/* -------------------------------------------------------------------------- */
/*                                    ALARM                                   */
/* -------------------------------------------------------------------------- */

static void Alarm_SetState(BOOL is_on, uint16_t period) {
    static BOOL ring_flag = FALSE;
    static uint16_t last_period = 0;
    if (period != last_period) {
        __HAL_TIM_SetCounter(&htim2, 0);
        __HAL_TIM_SET_AUTORELOAD(&htim2, period);
        __HAL_TIM_SET_COMPARE(&htim2, TIM_CHANNEL_2, (period >> 1));
        last_period = period;
    }
    if (is_on && !ring_flag) {
        HAL_TIM_PWM_Start(&htim2, TIM_CHANNEL_2);
        ring_flag = 1;
        HAL_GPIO_WritePin(LED_ONBOARD_GPIO_Port, LED_ONBOARD_Pin, GPIO_PIN_SET);
        return;
    }
    if (!is_on && ring_flag) {
        HAL_TIM_PWM_Stop(&htim2, TIM_CHANNEL_2);
        HAL_GPIO_WritePin(LED_ONBOARD_GPIO_Port, LED_ONBOARD_Pin, GPIO_PIN_RESET);
        ring_flag = 0;
        return;
    }
}

static void Alarm_Load() {
    uint32_t state1 = HAL_RTCEx_BKUPRead(&hrtc, RTC_BKP_DR2);
    uint32_t state2 = HAL_RTCEx_BKUPRead(&hrtc, RTC_BKP_DR3);
    uint32_t state3 = HAL_RTCEx_BKUPRead(&hrtc, RTC_BKP_DR4);
    if (state1 == 0 || (state1 & 0xFF) == 0) {
        enable_alarm = FALSE;
    } else {
        enable_alarm = TRUE;
    }
    alarm_time.Hours = (state2 >> 8) & 0xFF;
    alarm_time.Minutes = state2 & 0xFF;
    alarm_time.Seconds = (state1 >> 8) & 0xFF;

    alarm_music = state3 & 0xFF;
}

static void Alarm_Save() {
    uint32_t state1 = 0;
    uint32_t state2 = 0;
    uint32_t state3 = alarm_music;
    if (enable_alarm) state1 |= 0x01;
    state1 |= alarm_time.Seconds << 8;
    state2 |= alarm_time.Minutes;
    state2 |= alarm_time.Hours << 8;
    HAL_RTCEx_BKUPWrite(&hrtc, RTC_BKP_DR2, state1);
    HAL_RTCEx_BKUPWrite(&hrtc, RTC_BKP_DR3, state2);
    HAL_RTCEx_BKUPWrite(&hrtc, RTC_BKP_DR4, state3);
}

#define NYAN_CAT_LENGTH 32
#define NYAN_CAT_SPEED 3
uint32_t nyan_cat_data[] = {
    0xd1e1ab18, 0x98717191, 0xa19879bd, 0xebd9b797, 0xb1d1ebd9, 0xb7ab9879,
    0xa1789d9a, 0x87917191, 0xd1e1ab18, 0x98717191, 0xa19879bd, 0xebd9b797,
    0xb1d1ebd9, 0xb7ab9879, 0xa1789d9a, 0x87917171, 0x71457145, 0x79b7cbcd,
    0x71714574, 0xcb973234, 0x71457145, 0x779b7454, 0x71767457, 0xcbcd7161,
    0x71457145, 0x79b7cbcd, 0x71714574, 0xcb973234, 0x71457145, 0x779b7454,
    0x71767457, 0xcbcd7191,
};

#define ONLY_MY_RAILGUN_LENGTH 32
#define ONLY_MY_RAILGUN_SPEED 3
uint32_t only_my_railgun_data[] = {
    0x21031021, 0x00716141, 0x41551141, 0x41551141, 0x41551151, 0x51617191,
    0x61114111, 0xc1119111, 0x911911b1, 0x00716141, 0x41551141, 0x41551141,
    0x41551151, 0x51617191, 0x51111111, 0x51617191, 0x61141121, 0x00716141,
    0x41551141, 0x41551141, 0x41551151, 0x51617191, 0x51111111, 0x51617191,
    0x61114111, 0x21114111, 0x41551171, 0x61421141, 0x41551111, 0x11111111,
    0x11111111, 0x11111111,
};

uint16_t note_period_b[] = {
    0,     0,     25723, 24242, 21621, 19277, 17167, 16194,
    15238, 14440, 13628, 12861, 12139, 10810, 9638,
};

#define ZENBON_ZAKURA_LENGTH 80
#define ZENBON_ZAKURA_SPEED 2
uint32_t zenbon_zakura_data[] = {
    0x91a16565, 0x91a16565, 0x91a16565, 0x81716151, 0x91a16565, 0x91a16565,
    0x91a1c1f1, 0xefedc1a1, 0x91a16565, 0x91a16565, 0x91a16565, 0x81716151,
    0xa9acdca9, 0x6181a1c1, 0xd1d111c1, 0xd1111111, 0x61116115, 0x618191a1,
    0x61116115, 0x61513151, 0x61116115, 0x618191a1, 0xa1119111, 0x81116111,
    0x61116115, 0x618191a1, 0x61116115, 0x61513151, 0x61116115, 0x51618191,
    0xa1119111, 0x81116111, 0x81117111, 0x61115111, 0x51563121, 0x31111111,
    0x31516111, 0x91117111, 0x81117151, 0x61111111, 0x81117111, 0x61115111,
    0x51563121, 0x31113151, 0x61611161, 0x81119111, 0x71111111, 0x11116181,
    0x911911a1, 0xa11111a1, 0xc1d19181, 0xa1116181, 0x919111a1, 0xa111a1a1,
    0xb1a19181, 0x81116181, 0x911911a1, 0xa11111a1, 0xc1d19181, 0xa1116181,
    0xb111a111, 0x91118111, 0x81917151, 0x61116181, 0x911911a1, 0xa11111a1,
    0xc1d19181, 0xa1116181, 0x919111a1, 0xa111a1a1, 0xb1a19181, 0x81116181,
    0x911911a1, 0xa11111a1, 0xc1d19181, 0xa1116181, 0xb111a111, 0x91118111,
    0x9181a1c1, 0xd1111111,

};

uint16_t note_period_f[] = {0,     0,     20408, 18181, 17167, 15296,
                            13628, 12139, 11461, 10204, 9090,  8583,
                            7648,  6808,  6065,  5726};

int music_alt, music_tick, music_speed;
uint32_t *music_ptr;
uint32_t *music_end;
uint16_t *note_period;
int last_note;
static void Alarm_InitMusic(int id) {
    music_alt = music_tick = 0;
    last_note = 2;
    switch (id) {
        case MUSIC_NYAN_CAT:
            music_ptr = nyan_cat_data;
            music_end = nyan_cat_data + NYAN_CAT_LENGTH;
            music_speed = NYAN_CAT_SPEED;
            note_period = note_period_b;
            break;
        case MUSIC_ONLY_MY_RAILGUN:
            music_ptr = only_my_railgun_data;
            music_end = only_my_railgun_data + ONLY_MY_RAILGUN_LENGTH;
            music_speed = ONLY_MY_RAILGUN_SPEED;
            note_period = note_period_b;
            break;
        case MUSIC_ZENBON_ZAKURA:
            music_ptr = zenbon_zakura_data;
            music_end = zenbon_zakura_data + ZENBON_ZAKURA_LENGTH;
            music_speed = ZENBON_ZAKURA_SPEED;
            note_period = note_period_f;
            break;
        default:
            music_ptr = NULL;
            break;
    }
}
static void Alarm_TickMusic() {
    if (music_ptr == NULL || music_ptr >= music_end) {
        Alarm_StopMusic();
        return;
    };
    music_tick++;
    if (music_tick % music_speed == 0) {
        music_alt++;
        if (music_alt >= 8) {
            music_alt = 0;
            music_ptr++;
            if (music_ptr >= music_end) {
                Alarm_StopMusic();
                return;
            }
        }
    }
    int cur = ((*music_ptr) >> ((7 - music_alt) * 4)) & 0xF;
    if (cur == 0) {
        Alarm_SetState(FALSE, note_period[last_note]);
    } else if (cur == 1) {
        Alarm_SetState(TRUE, note_period[last_note]);
    } else {
        if (music_tick % music_speed != 0) {
            Alarm_SetState(TRUE, note_period[cur]);
            last_note = cur;
        } else {
            Alarm_SetState(FALSE, note_period[cur]);
        }
    }
}
static void Alarm_StopMusic() {
    Alarm_SetState(FALSE, 0xC00);
    music_ptr = NULL;
}

/* -------------------------------------------------------------------------- */
/*                                    DHT11                                   */
/* -------------------------------------------------------------------------- */

static void delay_us(uint32_t us) {
    __IO uint32_t currentTicks = SysTick->VAL;
    /* Number of ticks per millisecond */
    const uint32_t tickPerMs = SysTick->LOAD + 1;
    /* Number of ticks to count */
    const uint32_t nbTicks = ((us - ((us > 0) ? 1 : 0)) * tickPerMs) / 1000;
    /* Number of elapsed ticks */
    uint32_t elapsedTicks = 0;
    __IO uint32_t oldTicks = currentTicks;
    do {
        currentTicks = SysTick->VAL;
        elapsedTicks += (oldTicks < currentTicks)
                            ? tickPerMs + oldTicks - currentTicks
                            : oldTicks - currentTicks;
        oldTicks = currentTicks;
    } while (nbTicks > elapsedTicks);
}

void Set_Pin_Output(GPIO_TypeDef *GPIOx, uint16_t GPIO_Pin) {
    GPIO_InitTypeDef GPIO_InitStruct = {0};
    GPIO_InitStruct.Pin = GPIO_Pin;
    GPIO_InitStruct.Mode = GPIO_MODE_OUTPUT_PP;
    GPIO_InitStruct.Speed = GPIO_SPEED_FREQ_LOW;
    HAL_GPIO_Init(GPIOx, &GPIO_InitStruct);
}

void Set_Pin_Input(GPIO_TypeDef *GPIOx, uint16_t GPIO_Pin) {
    GPIO_InitTypeDef GPIO_InitStruct = {0};
    GPIO_InitStruct.Pin = GPIO_Pin;
    GPIO_InitStruct.Mode = GPIO_MODE_INPUT;
    GPIO_InitStruct.Pull = GPIO_PULLUP;
    HAL_GPIO_Init(GPIOx, &GPIO_InitStruct);
}

void DHT11_Start(void) {
    Set_Pin_Output(DHT11_GPIO_Port, DHT11_Pin);
    HAL_GPIO_WritePin(DHT11_GPIO_Port, DHT11_Pin, 0);
    delay_us(18000);
    HAL_GPIO_WritePin(DHT11_GPIO_Port, DHT11_Pin, 1);
    delay_us(20);
    Set_Pin_Input(DHT11_GPIO_Port, DHT11_Pin);
}

int DHT11_WaitFor(int state) {
    int timer = 0;
    while (HAL_GPIO_ReadPin(DHT11_GPIO_Port, DHT11_Pin) != state) {
        delay_us(1);
        timer++;
        if (timer > 1000) {
            return 1;
        }
    }
    return 0;
}

uint8_t DHT11_Check_Response(void) {
    uint8_t Response = 0;

    delay_us(40);
    if (!(HAL_GPIO_ReadPin(DHT11_GPIO_Port, DHT11_Pin))) {
        delay_us(80);
        if ((HAL_GPIO_ReadPin(DHT11_GPIO_Port, DHT11_Pin)))
            Response = 1;
        else
            Response = -1;
    }
    if (DHT11_WaitFor(0)) return -1;

    return Response;
}

uint8_t DHT11_Read(void) {
    uint8_t i = 0, j = 0;
    for (j = 0; j < 8; j++) {
        if (DHT11_WaitFor(1)) return 0;
        delay_us(40);
        if (!(HAL_GPIO_ReadPin(DHT11_GPIO_Port, DHT11_Pin))) {
            i &= ~(1 << (7 - j));
        } else
            i |= (1 << (7 - j));
        if (DHT11_WaitFor(0)) return 0;
    }
    return i;
}

static void DHT11_Run() {
    DHT11_Start();
    int Presence = DHT11_Check_Response();
    if (Presence == 1) {
        uint8_t Rh_byte1 = DHT11_Read();
        uint8_t Rh_byte2 = DHT11_Read();
        uint8_t Temp_byte1 = DHT11_Read();
        uint8_t Temp_byte2 = DHT11_Read();
        uint8_t SUM = DHT11_Read();

        if (Rh_byte1 + Rh_byte2 + Temp_byte1 + Temp_byte2 != SUM) {
            UART_Write_Text("DHT11 validation failed.");
        }

        temp = Temp_byte1;
        humi = Rh_byte1;
        UART_Write_Text("Temp: ");
        UART_Write_Int(temp);
        UART_Write_NewLine();
        UART_Write_Text("RH: ");
        UART_Write_Int(humi);
    } else {
        UART_Write_Text("No response from DHT11");
    }
}

/* -------------------------------------------------------------------------- */
/*                                     APP                                    */
/* -------------------------------------------------------------------------- */

static void App_Tick() {
    switch (page) {
        case PAGE_HOME:
            App_HomePage();
            break;
        case PAGE_ALARM:
            App_AlarmPage();
            break;
        case PAGE_MENU:
            App_MenuPage();
            break;
        case PAGE_SET_TIME:
            App_SetTimePage();
            break;
        case PAGE_TEMP_HUMI:
            App_TempHumiPage();
            break;
        case PAGE_SET_ALARM:
            App_SetAlarmPage();
            break;
        case PAGE_MUSIC:
            App_MusicPage();
            break;
        case PAGE_STOPWATCH:
            App_StopwatchPage();
            break;
        case PAGE_COUNTDOWN:
            App_CountdownPage();
            break;
        default:
            page = PAGE_HOME;
            break;
    }
}

static void App_HomePage() {
    static int screen = 0;
    switch (screen) {
        case SCREEN_HM:
            Display_SetCurrentTimeHM();
            break;
        case SCREEN_MS:
            Display_SetCurrentTimeMS();
            break;
    }
    if (enable_alarm) {
        if (sTime.Hours == alarm_time.Hours &&
            sTime.Minutes == alarm_time.Minutes &&
            sTime.Seconds == alarm_time.Seconds) {
            page = PAGE_ALARM;
            return;
        }
    }
    if (KEY_R) {
        if (screen < 1) {
            screen++;
        } else {
            screen = 0;
        }
        return;
    }
    if (KEY_L) {
        if (screen > 0) {
            screen--;
        } else {
            screen = 1;
        }
    }
    if (KEY_U || KEY_D) {
        page = PAGE_MENU;
        return;
    }
}

BOOL App_MenuOption(int cursor) {
    switch (cursor) {
        case 0:
            page = PAGE_SET_TIME;
            break;
        case 1:
            page = PAGE_TEMP_HUMI;
            break;
        case 2:
            page = PAGE_COUNTDOWN;
            break;
        case 3:
            page = PAGE_STOPWATCH;
            break;
        case 4:
            enable_alarm = !enable_alarm;
            Alarm_Save();
            return FALSE;
        case 5:
            page = PAGE_SET_ALARM;
            break;
        case 6:
            page = PAGE_MUSIC;
            break;
        case 7:
            page = PAGE_HOME;
            break;
        default:
            return FALSE;
    }
    return TRUE;
}

static void App_MenuPage() {
    static int cursor = 0;
    if (cursor < 0 || cursor > 7) {
        cursor = 0;
    }
    display_buffer[0] = display_buffer[1] = display_buffer[2] =
        display_buffer[3] = 0;
    if (enable_alarm) display_buffer[0] |= LED_DP_Pin;
    if (cursor < 4) {
        display_buffer[cursor] |= LED_A_Pin;
        if (KEY_U) {
            if (App_MenuOption(cursor)) cursor = 0;
            return;
        }
        if (KEY_D) {
            cursor += 4;
            return;
        }
    } else {
        display_buffer[cursor - 4] |= LED_D_Pin;
        if (KEY_D) {
            if (App_MenuOption(cursor)) cursor = 0;
            return;
        }
        if (KEY_U) {
            cursor -= 4;
            return;
        }
    }
    if (KEY_L) {
        if (cursor > 0) cursor--;
        return;
    }
    if (KEY_R) {
        if (cursor < 7) cursor++;
    }
}

static void App_SetTimePage() {
    static int cursor = -1;
    static char buffer[4] = {0};
    if (cursor == -1) {
        buffer[0] = sTime.Hours / 16 + '0';
        buffer[1] = sTime.Hours % 16 + '0';
        buffer[2] = sTime.Minutes / 16 + '0';
        buffer[3] = sTime.Minutes % 16 + '0';
        cursor = 0;

        Keys_SetMode(KEY_ID_U, KEY_MODE_LONG);
        Keys_SetMode(KEY_ID_D, KEY_MODE_LONG);
    }

    if (sTime.Seconds & 1) {
        Display_SetChar(buffer, TRUE);
    } else {
        char buffer1[] = {0};
        buffer1[cursor] = buffer[cursor];
        Display_SetChar(buffer1, TRUE);
    }

    if (KEY_R) {
        if (cursor >= 3) {
            cursor = -1;
            sTime.Hours = ((buffer[0] - '0') << 4) + (buffer[1] - '0');
            sTime.Minutes = ((buffer[2] - '0') << 4) + (buffer[3] - '0');
            sTime.Seconds = 0x00;
            HAL_RTC_SetTime(&hrtc, &sTime, RTC_FORMAT_BCD);

            Keys_SetMode(KEY_ID_U, KEY_MODE_ONCE);
            Keys_SetMode(KEY_ID_D, KEY_MODE_ONCE);
            page = PAGE_HOME;
        } else {
            cursor++;
        }
        return;
    }
    if (KEY_L) {
        if (cursor <= 0) {
            cursor = -1;
            page = PAGE_HOME;
        } else {
            cursor--;
        }
        return;
    }
    if (KEY_U) {
        char upper = '0';
        switch (cursor) {
            case 0:
                upper = '2';
                break;
            case 1:
                if (buffer[0] == '2') {
                    upper = '3';
                } else {
                    upper = '9';
                }
                break;
            case 2:
                upper = '5';
                break;
            case 3:
                upper = '9';
                break;
        }
        if (buffer[cursor] < upper) {
            buffer[cursor]++;
            if (cursor == 0 && buffer[0] == '2' && buffer[1] > '3') {
                buffer[1] = '3';
            }
        }
        return;
    }
    if (KEY_D) {
        if (buffer[cursor] > '0') {
            buffer[cursor]--;
        }
    }
}

static void App_AlarmPage() {
    static BOOL ringing = FALSE;

    if (!ringing) {
        ringing = TRUE;
        Alarm_InitMusic(alarm_music);
    }

    if (alarm_music) {
        Alarm_TickMusic();
    }

    if (sTime.Seconds & 1) {
        Display_SetChar("8888", FALSE);
        if (alarm_music == 0) {
            Alarm_SetState(TRUE, 0xC00);
        }
    } else {
        Display_SetCurrentTimeHM();
        if (alarm_music == 0) {
            Alarm_SetState(FALSE, 0xC00);
        }
    }

    if (KEY_L || KEY_R || KEY_U || KEY_D ||
        (alarm_music && music_ptr == NULL)) {
        Alarm_StopMusic();
        ringing = FALSE;
        page = PAGE_HOME;
        return;
    }
}

static void App_TempHumiPage() {
    static int stage = 0;
    if (stage == 0) {
        DHT11_Run();
        stage = 1;
    }
    if (stage == 1) {
        Display_SetInt(temp);
    }
    if (stage == 2) {
        Display_SetInt(humi);
    }
    if (KEY_R) {
        stage++;
        if (stage > 2) {
            stage = 0;
            page = PAGE_HOME;
            return;
        }
    }
}

static void App_SetAlarmPage() {
    static int cursor = -1;
    static char buffer[4] = {0};
    if (cursor == -1) {
        buffer[0] = alarm_time.Hours / 16 + '0';
        buffer[1] = alarm_time.Hours % 16 + '0';
        buffer[2] = alarm_time.Minutes / 16 + '0';
        buffer[3] = alarm_time.Minutes % 16 + '0';
        cursor = 0;

        Keys_SetMode(KEY_ID_U, KEY_MODE_LONG);
        Keys_SetMode(KEY_ID_D, KEY_MODE_LONG);
    }

    if (sTime.Seconds & 1) {
        Display_SetChar(buffer, TRUE);
    } else {
        char buffer1[] = {0};
        buffer1[cursor] = buffer[cursor];
        Display_SetChar(buffer1, TRUE);
    }

    if (KEY_R) {
        if (cursor >= 3) {
            cursor = -1;
            alarm_time.Hours = ((buffer[0] - '0') << 4) + (buffer[1] - '0');
            alarm_time.Minutes = ((buffer[2] - '0') << 4) + (buffer[3] - '0');
            alarm_time.Seconds = 0x00;
            Alarm_Save();
            Keys_SetMode(KEY_ID_U, KEY_MODE_ONCE);
            Keys_SetMode(KEY_ID_D, KEY_MODE_ONCE);

            page = PAGE_HOME;
        } else {
            cursor++;
        }
        return;
    }
    if (KEY_L) {
        if (cursor <= 0) {
            cursor = -1;
            page = PAGE_HOME;
        } else {
            cursor--;
        }
        return;
    }
    if (KEY_U) {
        char upper = '0';
        switch (cursor) {
            case 0:
                upper = '2';
                break;
            case 1:
                if (buffer[0] == '2') {
                    upper = '3';
                } else {
                    upper = '9';
                }
                break;
            case 2:
                upper = '5';
                break;
            case 3:
                upper = '9';
                break;
        }
        if (buffer[cursor] < upper) {
            buffer[cursor]++;
            if (cursor == 0 && buffer[0] == '2' && buffer[1] > '3') {
                buffer[1] = '3';
            }
        }
        return;
    }
    if (KEY_D) {
        if (buffer[cursor] > '0') {
            buffer[cursor]--;
        }
    }
}

static void App_MusicPage() {
    Display_SetInt(alarm_music);
    Alarm_TickMusic();
    if (KEY_L) {
        page = PAGE_HOME;
        Alarm_StopMusic();
        return;
    }
    if (KEY_U) {
        if (alarm_music < 3) {
            alarm_music++;
            Alarm_Save();
        }
        return;
    }
    if (KEY_D) {
        if (alarm_music > 0) {
            alarm_music--;
            Alarm_Save();
        }
        return;
    }
    if (KEY_R) {
        Alarm_InitMusic(alarm_music);
        return;
    }
}

static void App_StopwatchPage() {
    static int start_timestamp = 0;
    static int time_passed = 0;
    static BOOL running = FALSE;
    static int screen = SCREEN_MS;
    int current_timestamp =
        second_timestamp * 1000 + __HAL_TIM_GetCounter(&htim3);
    if (running) {
        int total = current_timestamp - start_timestamp + time_passed;
        Display_SetTimestamp(total, screen);
    } else {
        Display_SetTimestamp(time_passed, screen);
    }
    switch (screen) {
        case SCREEN_HM:
            display_buffer[0] |= LED_DP_Pin;
            break;
        case SCREEN_MS:
            display_buffer[2] |= LED_DP_Pin;
            break;
        case SCREEN_SM:
            display_buffer[3] |= LED_DP_Pin;
            break;
    }
    if (KEY_L) {
        if (screen > 0) {
            screen--;
        }
        return;
    }
    if (KEY_R) {
        if (screen < 2) {
            screen++;
        }
        return;
    }
    if (KEY_U) {
        if (running) {
            running = FALSE;
            time_passed += current_timestamp - start_timestamp;
        } else {
            running = TRUE;
            start_timestamp = current_timestamp;
        }
        return;
    }
    if (KEY_D) {
        if (!running) {
            if (time_passed == 0) {
                page = PAGE_HOME;
            } else {
                time_passed = 0;
            }
        }
    }
}
static void App_CountdownPage() {
    static int stage = 0;
    static int hours = 0;
    static int minutes = 10;
    static int seconds = 0;

    static BOOL running = FALSE;
    static int start_timestamp = 0;
    static int remain_time = 0;
    static int screen = SCREEN_MS;

    if (stage <= 2) {
        Keys_SetMode(KEY_ID_U, KEY_MODE_LONG_ACC);
        Keys_SetMode(KEY_ID_D, KEY_MODE_LONG_ACC);
    } else {
        Keys_SetMode(KEY_ID_U, KEY_MODE_ONCE);
        Keys_SetMode(KEY_ID_D, KEY_MODE_ONCE);
    }
    int current_timestamp =
        second_timestamp * 1000 + __HAL_TIM_GetCounter(&htim3);
    char buf[4] = {0};
    switch (stage) {
        case 0:
            buf[0] = hours / 10 + '0';
            buf[1] = hours % 10 + '0';
            if (sTime.Seconds & 1) {
                buf[2] = minutes / 10 + '0';
                buf[3] = minutes % 10 + '0';
            }
            Display_SetChar(buf, TRUE);
            display_buffer[0] |= LED_DP_Pin;
            if (KEY_U) {
                if (hours < 99) hours++;
                return;
            }
            if (KEY_D) {
                if (hours > 0) hours--;
                return;
            }
            if (KEY_L) {
                page = PAGE_HOME;
                Keys_SetMode(KEY_ID_U, KEY_MODE_ONCE);
                Keys_SetMode(KEY_ID_D, KEY_MODE_ONCE);
                return;
            }
            if (KEY_R) {
                stage = 1;
                return;
            }
            break;
        case 1:
            if (sTime.Seconds & 1) {
                buf[0] = hours / 10 + '0';
                buf[1] = hours % 10 + '0';
            }
            buf[2] = minutes / 10 + '0';
            buf[3] = minutes % 10 + '0';
            Display_SetChar(buf, TRUE);
            display_buffer[0] |= LED_DP_Pin;
            if (KEY_U) {
                if (minutes < 59)
                    minutes++;
                else
                    minutes = 0;
                return;
            }
            if (KEY_D) {
                if (minutes > 0)
                    minutes--;
                else
                    minutes = 59;
                return;
            }
            if (KEY_L) {
                stage = 0;
                return;
            }
            if (KEY_R) {
                stage = 2;
                return;
            }
            break;
        case 2:
            if (sTime.Seconds & 1) {
                buf[0] = minutes / 10 + '0';
                buf[1] = minutes % 10 + '0';
            }
            buf[2] = seconds / 10 + '0';
            buf[3] = seconds % 10 + '0';
            Display_SetChar(buf, TRUE);
            display_buffer[2] |= LED_DP_Pin;
            if (KEY_U) {
                if (seconds < 59)
                    seconds++;
                else
                    seconds = 0;
                return;
            }
            if (KEY_D) {
                if (seconds > 0)
                    seconds--;
                else
                    seconds = 59;
                return;
            }
            if (KEY_L) {
                stage = 0;
                return;
            }
            if (KEY_R) {
                remain_time =
                    hours * 3600 * 1000 + minutes * 60 * 1000 + seconds * 1000;
                if (remain_time > 0) {
                    running = TRUE;
                    start_timestamp = current_timestamp;
                    Keys_SetMode(KEY_ID_U, KEY_MODE_ONCE);
                    Keys_SetMode(KEY_ID_D, KEY_MODE_ONCE);
                    stage = 3;
                }
                return;
            }
            break;
        case 3:
            if (running) {
                if (current_timestamp >= start_timestamp + remain_time) {
                    stage = 0;
                    page = PAGE_ALARM;
                    return;
                } else {
                    Display_SetTimestamp(
                        start_timestamp + remain_time - current_timestamp,
                        screen);
                }
            } else {
                Display_SetTimestamp(remain_time, screen);
            }
            switch (screen) {
                case SCREEN_HM:
                    display_buffer[0] |= LED_DP_Pin;
                    break;
                case SCREEN_MS:
                    display_buffer[2] |= LED_DP_Pin;
                    break;
                case SCREEN_SM:
                    display_buffer[3] |= LED_DP_Pin;
                    break;
            }
            if (KEY_L) {
                if (screen > 0) {
                    screen--;
                }
                return;
            }
            if (KEY_R) {
                if (screen < 2) {
                    screen++;
                }
                return;
            }
            if (KEY_U) {
                if (running) {
                    running = FALSE;
                    remain_time -= current_timestamp - start_timestamp;
                } else {
                    running = TRUE;
                    start_timestamp = current_timestamp;
                }
                return;
            }
            if (KEY_D) {
                if (!running) {
                    stage = 0;
                    page = PAGE_HOME;
                }
            }
    }
}
/* USER CODE END 4 */
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
