Duanyll/LedClock/LedClock.ioc

Mcu.UserName=STM32F103C6Tx
PA0-WKUP.GPIO_Label=DHT11
PA0-WKUP.Signal=GPIO_Output
PA1.Signal=S_TIM2_CH2
PA10.Signal=S_TIM1_CH3
PA11.Signal=S_TIM1_CH4
PA13.Signal=SYS_JTMS-SWDIO
PA14.Signal=SYS_JTCK-SWCLK
PA2.Signal=USART2_TX
PA3.Signal=USART2_RX
PA8.Signal=S_TIM1_CH1
PA9.Signal=S_TIM1_CH2
PB0.GPIO_Label=LED_A
PB0.Signal=GPIO_Output
PB1.Signal=ADCx_IN9
PB10.GPIO_Label=LED_F
PB10.Signal=GPIO_Output
PB11.GPIO_Label=LED_B
PB11.Signal=GPIO_Output
PB12.GPIO_Label=BTN_U
PB12.Signal=GPIO_Input
PB13.GPIO_Label=BTN_R
PB13.Signal=GPIO_Input
PB14.GPIO_Label=BTN_D
PB14.Signal=GPIO_Input
PB15.GPIO_Label=BTN_L
PB15.Signal=GPIO_Input
PB3.GPIO_Label=LED_G
PB3.Signal=GPIO_Output
PB4.GPIO_Label=LED_C
PB4.Signal=GPIO_Output
PB5.GPIO_Label=LED_D
PB5.Signal=GPIO_Output
PB6.GPIO_Label=LED_E
PB6.Signal=GPIO_Output
PB7.GPIO_Label=LED_DP
PB7.Signal=GPIO_Output
PC13-TAMPER-RTC.GPIO_Label=LED_ONBOARD
PC13-TAMPER-RTC.Signal=GPIO_Output
PC14-OSC32_IN.Signal=RCC_OSC32_IN
PC15-OSC32_OUT.Signal=RCC_OSC32_OUT
PD0-OSC_IN.Signal=RCC_OSC_IN
PD1-OSC_OUT.Signal=RCC_OSC_OUT
