Duanyll/LedClock/Core/Inc/main.h

#define LED_ONBOARD_Pin GPIO_PIN_13
#define LED_ONBOARD_GPIO_Port GPIOC
#define DHT11_Pin GPIO_PIN_0
#define DHT11_GPIO_Port GPIOA
#define LED_A_Pin GPIO_PIN_0
#define LED_A_GPIO_Port GPIOB
#define LED_F_Pin GPIO_PIN_10
#define LED_F_GPIO_Port GPIOB
#define LED_B_Pin GPIO_PIN_11
#define LED_B_GPIO_Port GPIOB
#define BTN_U_Pin GPIO_PIN_12
#define BTN_U_GPIO_Port GPIOB
#define BTN_R_Pin GPIO_PIN_13
#define BTN_R_GPIO_Port GPIOB
#define BTN_D_Pin GPIO_PIN_14
#define BTN_D_GPIO_Port GPIOB
#define BTN_L_Pin GPIO_PIN_15
#define BTN_L_GPIO_Port GPIOB
#define LED_G_Pin GPIO_PIN_3
#define LED_G_GPIO_Port GPIOB
#define LED_C_Pin GPIO_PIN_4
#define LED_C_GPIO_Port GPIOB
#define LED_D_Pin GPIO_PIN_5
#define LED_D_GPIO_Port GPIOB
#define LED_E_Pin GPIO_PIN_6
#define LED_E_GPIO_Port GPIOB
#define LED_DP_Pin GPIO_PIN_7
#define LED_DP_GPIO_Port GPIOB
