Duanyll/LedClock/(commit log)

2021-10-06 简单led计数器
2021-10-06 按钮判定，亮度调节
2021-10-06 rtc时间显示和设置
2021-10-07 自动亮度调节
2021-10-13 加入蜂鸣器和dht11的代码
2021-10-17 瞎搞了一堆
2021-10-24 调整接线布局
2021-10-28 重构页面，音乐播放
2021-10-30 修改为google代码风格
2021-10-30 秒表和倒计时
2021-11-01 添加设计报告和license
2023-04-05 加了一行注释
